w1ne/thermal-io-link-condition-sensor/hardware/schematic.kicad_sch

## KiCad design hardware/schematic.kicad_sch (2026-06-28, last stored version)

Schematic: schematic.kicad_sch

Parts:
thermal-cam: MLX90640
thermal-m12: M12 IO-LINK CONNECTOR
thermal-mcu: ESP32-C3 SUPERMINI
thermal-reg: 24V -> 3V3 REGULATOR
