w1ne/thermal-io-link-condition-sensor/(commit log)

2026-06-28 Initial export of "Thermal IO-Link Condition Sensor" from proto.cat
    [bom.csv, schematic.kicad_sch]
2026-10-01 Restore thermal source, STEVAL wiring and honest source verification (#1)
    * Restore thermal source with MLX90640 and STEVAL IO-Link integration
    * Clamp thermal health before float to integer conversion
    [bom.csv, schematic.kicad_sch]
